petekaik/esp32-c3-sensor-board/case/renders/cand_a_stepped_iso.png

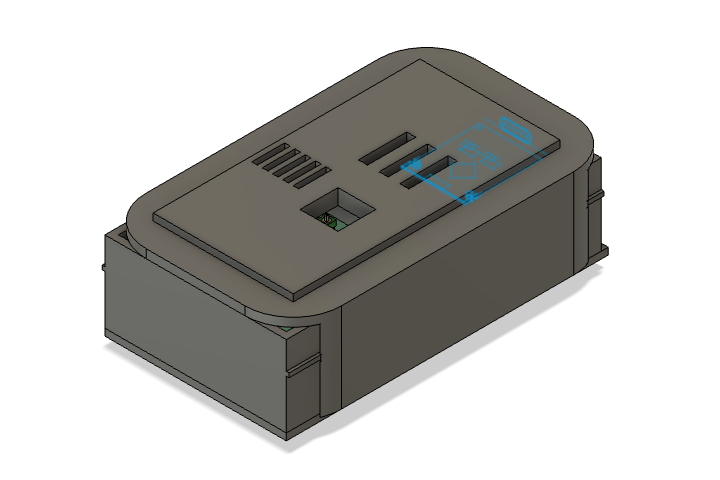
case/renders/cand_a_stepped_iso.png
