petekaik/esp32-c3-sensor-board/case/renders/cand_b_wavy_side.png

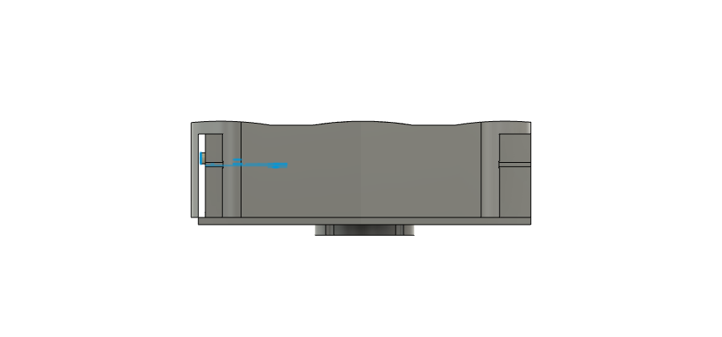
case/renders/cand_b_wavy_side.png
