petekaik/esp32-c3-sensor-board/case/renders/compact_case_faceplate.png

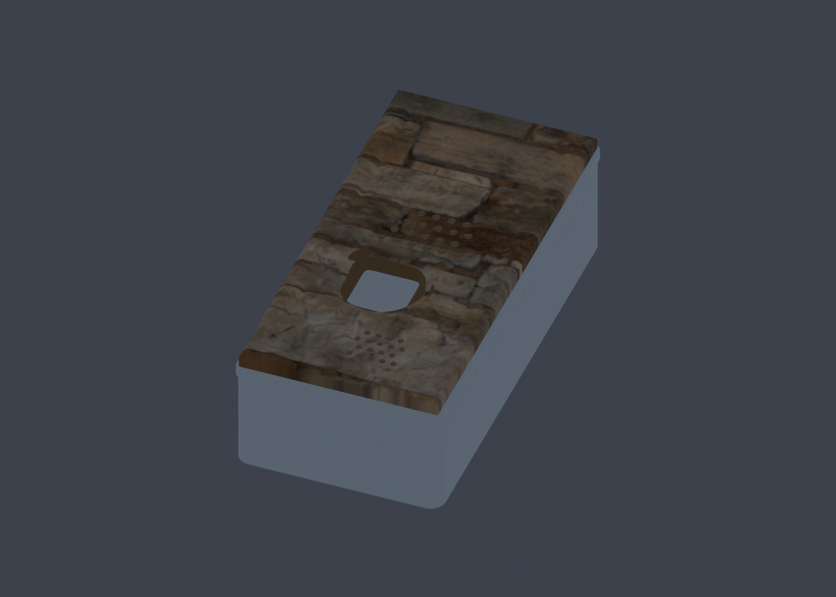
case/renders/compact_case_faceplate.png
