petekaik/esp32-c3-sensor-board/case/renders/faceplate_compact.png

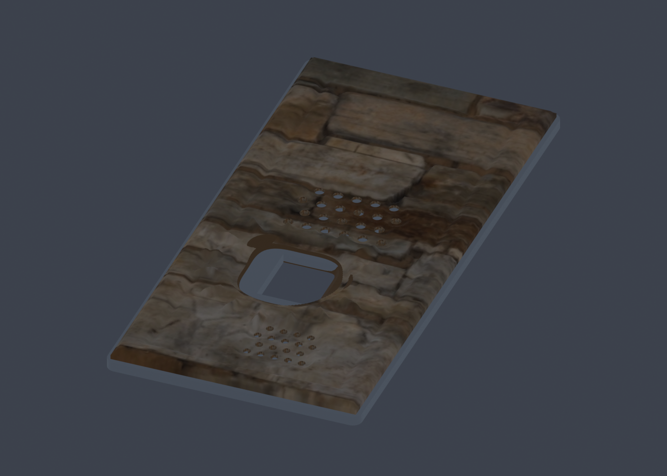
case/renders/faceplate_compact.png
