petekaik/esp32-c3-sensor-board/case/renders/faceplate_organic.png

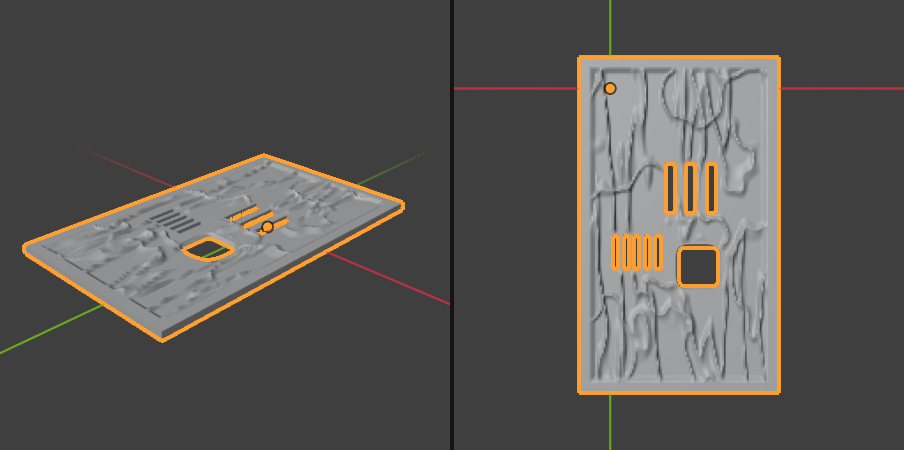
case/renders/faceplate_organic.png
