petekaik/esp32-c3-sensor-board/docs/img/board-compact.png

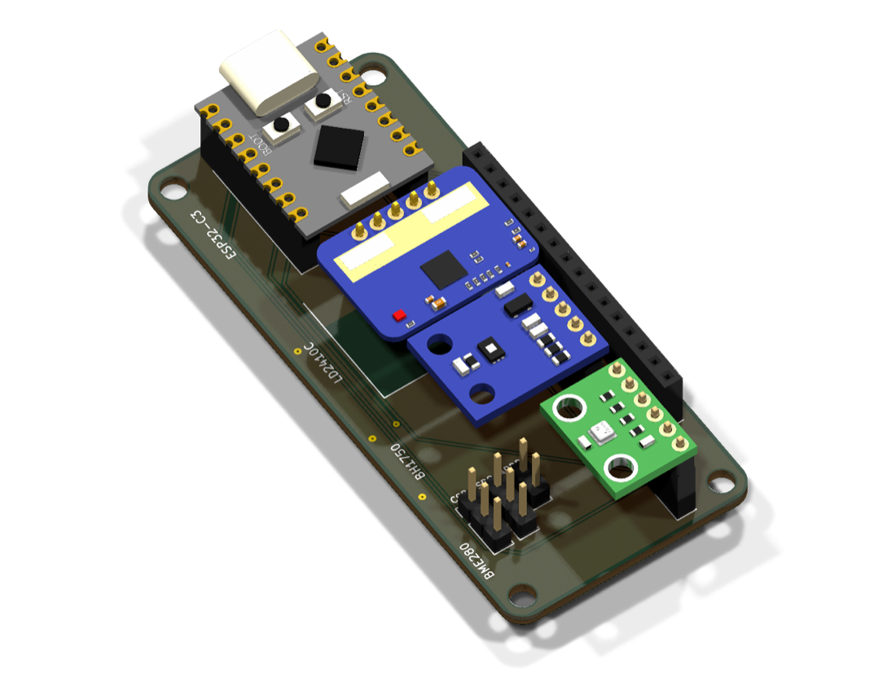
docs/img/board-compact.png
