petekaik/esp32-c3-sensor-board/docs/img/board-rev3.png

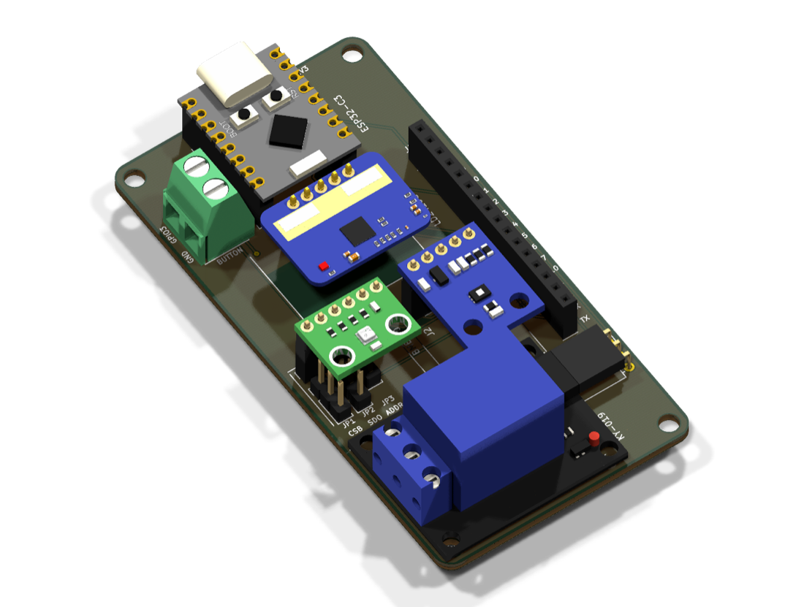
docs/img/board-rev3.png
