petekaik/esp32-c3-sensor-board/docs/BOM-compact.csv

Ref | Value | Footprint | Qty | Notes
PCB | ESP32-C3 sensor carrier compact | 2-layer 34 x 76 mm | 1 | 1.6 mm FR4 R3 corners ENIG preferred
U1 | ESP32-C3 Super Mini | module 2x8 2.54 mm | 1 | plugs into two 1x8 sockets
U2 | HLK-LD2410C | module 1x5 2.54 mm | 1 | plugs into 1x5 socket
J1 | BME280 module | module 1x6 2.54 mm | 1 | BME680 in the bme680 variant
J2 | BH1750 GY-302 | module 1x5 2.54 mm | 1
S1 | 1x8 female socket 2.54 mm | PinSocket_1x08_P2.54mm_Vertical | 2 | U1A/U1B
S2 | 1x5 female socket 2.54 mm | PinSocket_1x05_P2.54mm_Vertical | 2 | U2 and J2
S3 | 1x6 female socket 2.54 mm | PinSocket_1x06_P2.54mm_Vertical | 1 | J1
J5 | 1x16 female socket 2.54 mm | sensor-board:PinSocket_1x16_P2.54mm_Vertical | 1 | LCSC C7499334
JP1 | 1x3 pin header 2.54 mm | PinHeader_1x03_P2.54mm_Vertical | 1 | I2C / SPI select
JP2 | 1x3 pin header 2.54 mm | PinHeader_1x03_P2.54mm_Vertical | 1 | address / SPI MISO select
JP3 | 1x2 pin header 2.54 mm | PinHeader_1x02_P2.54mm_Vertical | 1 | address select
SHUNT | 2.54 mm jumper shunt | generic | 3 | one per jumper
H1-H4 | M3 mounting hole | 3.2 mm drill | 4 | no hardware included
