petekaik/esp32-c3-sensor-board/fabrication/bom-jlc.csv

Designator | Footprint | Quantity | Value | LCSC Part #
J1 | PinSocket_1x06_P2.54mm_Vertical | 1 | 1x6 female socket 2.54 mm | C40877
J2 | PinSocket_1x05_P2.54mm_Vertical | 1 | 1x5 female socket 2.54 mm | C50950
J4 | TerminalBlock_MaiXu_MX126-5.0-02P_1x02_P5.00mm | 1 | Button | C5188434
J5 | PinSocket_1x14_P2.54mm_Vertical | 1 | GPIO | C41417326
JP1 | PinHeader_1x03_P2.54mm_Vertical | 1 | CSB_I2C | C49257
JP2 | PinHeader_1x03_P2.54mm_Vertical | 1 | SDO_ADDR | C49257
JP3 | PinHeader_1x02_P2.54mm_Vertical | 1 | ADDR_GND | C32713268
U1A, U1B | PinSocket_1x08_P2.54mm_Vertical | 2 | 1x8 female socket 2.54 mm | C27438
U2 | ld2410c | 1 | 1x5 female socket 2.54 mm | C50950
