petekaik/esp32-c3-sensor-board/fabrication/assembly/vendor-neutral-bom.csv

Ref | Part | Footprint | Pitch | Qty | Notes | LCSC | Aisler MPN | PCBWay/JLC note
U1A | 1x8 female socket 2.54 mm | PinSocket_1x08_P2.54mm_Vertical | 2.54 | 1 | U1 pads 1-8 | C27438 | 2.54-1*8P
U1B | 1x8 female socket 2.54 mm | PinSocket_1x08_P2.54mm_Vertical | 2.54 | 1 | U1 pads 9-16 | C27438 | 2.54-1*8P
U2 | 1x5 female socket 2.54 mm | PinSocket_1x05_P2.54mm_Vertical | 2.54 | 1 | LD2410C socket | C50950 | 2.54-1*5P
J1 | 1x6 female socket 2.54 mm | PinSocket_1x06_P2.54mm_Vertical | 2.54 | 1 | BME280/BME680 | C40877 | 2.54-1*6P
J2 | 1x5 female socket 2.54 mm | PinSocket_1x05_P2.54mm_Vertical | 2.54 | 1 | BH1750 | C50950 | 2.54-1*5P
J3 | 1x3 right-angle female socket 2.54 mm | PinSocket_1x03_P2.54mm_Horizontal | 2.54 | 1 | relay; hand-solder long-pin | C54876732 | excluded - hand-solder
J4 | 2-pin screw terminal 5.0 mm | TerminalBlock_MaiXu_MX126-5.0-02P | 5.00 | 1 | button | C5188434 | MX126-5.0-02P-GN01-Cu-S-A
J5 | 1x14 female socket 2.54 mm | PinSocket_1x14_P2.54mm_Vertical | 2.54 | 1 | breakout row | C41417326 | SSW-114-01-T-S | LCSC code not in Aisler catalogue
JP1 | 1x3 pin header 2.54 mm | PinHeader_1x03_P2.54mm_Vertical | 2.54 | 1 | I2C/SPI select | C49257 | TSW-103-07-G-S
JP2 | 1x3 pin header 2.54 mm | PinHeader_1x03_P2.54mm_Vertical | 2.54 | 1 | address/SPI MISO | C49257 | TSW-103-07-G-S
JP3 | 1x2 pin header 2.54 mm | PinHeader_1x02_P2.54mm_Vertical | 2.54 | 1 | address | C32713268 | HX PZ2.54-1x2P ZZ
SHUNT | 2.54 mm jumper shunt | generic | 2.54 | 3 | one per jumper | C5305 | not in Aisler CAD BOM | hand-fit
 | ESP32-C3 Super Mini | module |  | 1 | EXCLUDED - plug-in
 | HLK-LD2410C | module |  | 1 | EXCLUDED - plug-in
 | BME280 (or BME680) | module |  | 1 | EXCLUDED - plug-in
 | BH1750 GY-302 | module |  | 1 | EXCLUDED - plug-in
 | KY-019 relay | module |  | 1 | EXCLUDED - plug-in
