petekaik/esp32-c3-sensor-board/case/compact_cover.stl

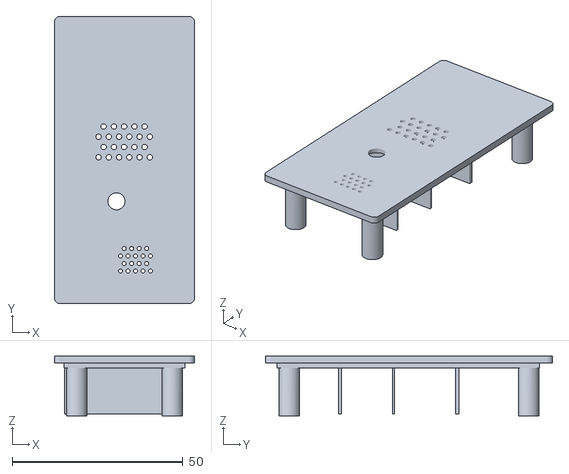
[picture p10: CAD file, 2026-11-02]
case/compact_cover.stl
41.0 x 84.0 x 17.5
