petekaik/esp32-c3-sensor-board/case/compact_tray.stl

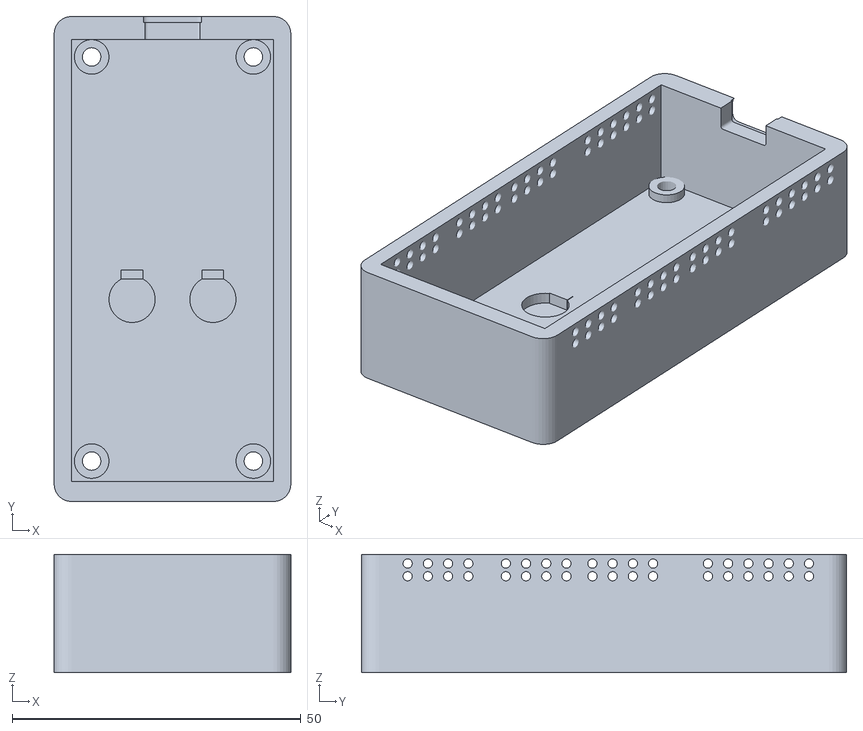
[picture p11: CAD file, 2026-11-01]
case/compact_tray.stl
41.0 x 84.0 x 20.5
