petekaik/esp32-c3-sensor-board/case/compact_mount.stl

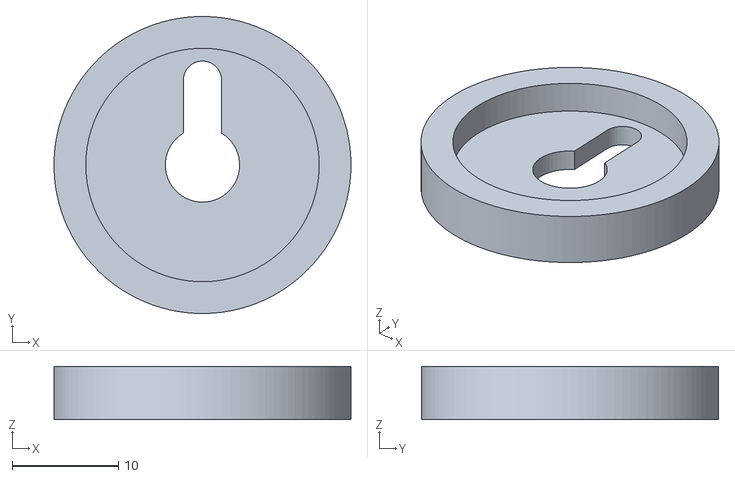
[picture p12: CAD file, 2026-11-01]
case/compact_mount.stl
28.0 x 28.0 x 5.00
