petekaik/esp32-c3-sensor-board/case/faceplate_compact.stl

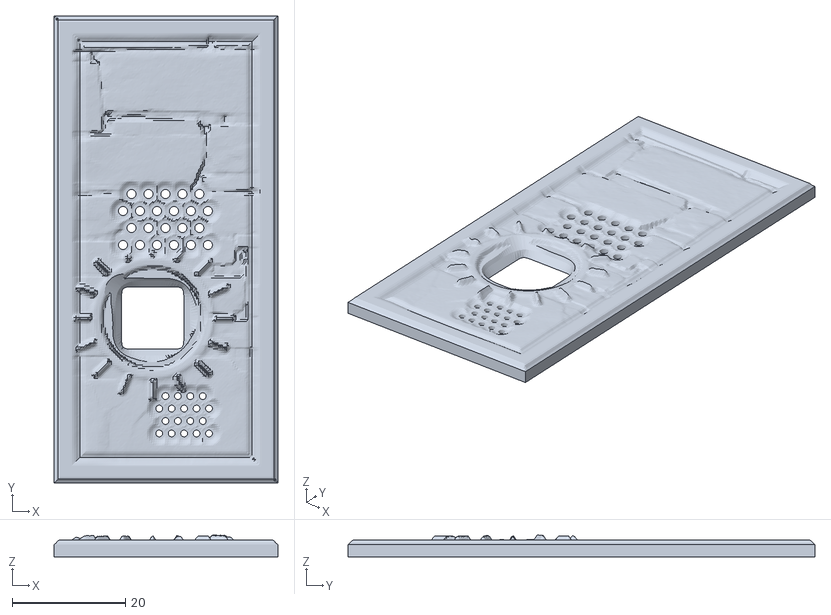
[picture p13: CAD file, 2026-11-01]
case/faceplate_compact.stl
39.5 x 82.5 x 3.85
