petekaik/esp32-c3-sensor-board/case/tray.stl

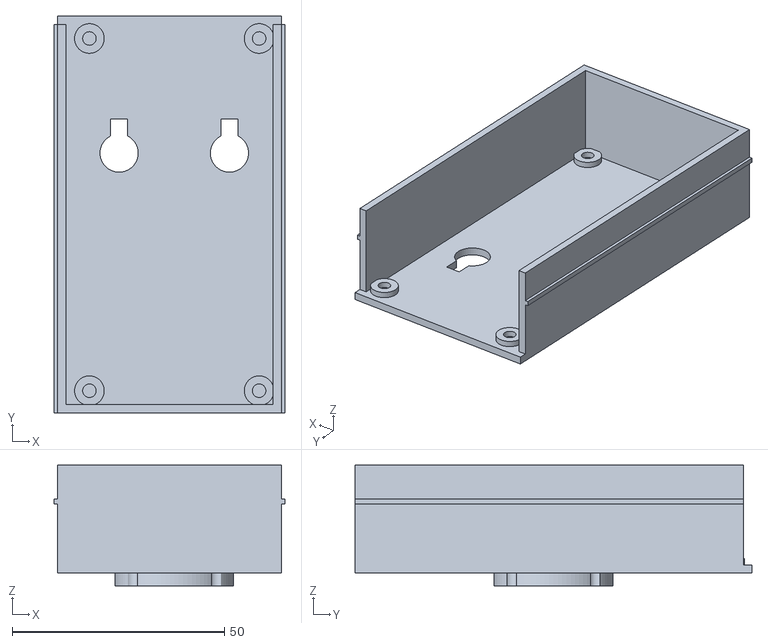
[picture p14: CAD file, 2026-10-31]
case/tray.stl
54.3 x 93.5 x 28.5
