petekaik/esp32-c3-sensor-board/case/faceplate.stl

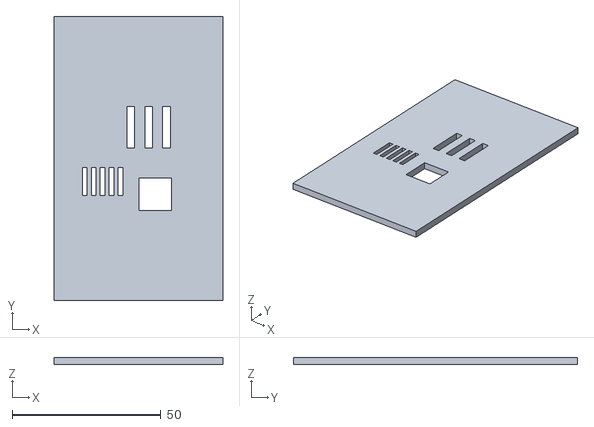
[picture p15: CAD file, 2026-10-31]
case/faceplate.stl
56.8 x 95.6 x 2.50
