petekaik/esp32-c3-sensor-board/case/faceplate_organic.stl

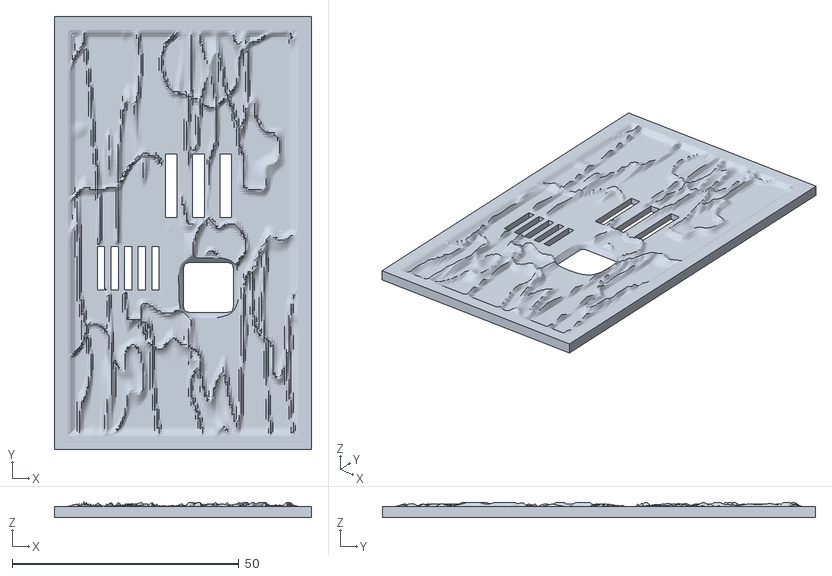
[picture p16: CAD file, 2026-10-31]
case/faceplate_organic.stl
56.8 x 95.6 x 3.35
