petekaik/esp32-c3-sensor-board/case/board-rev2.step

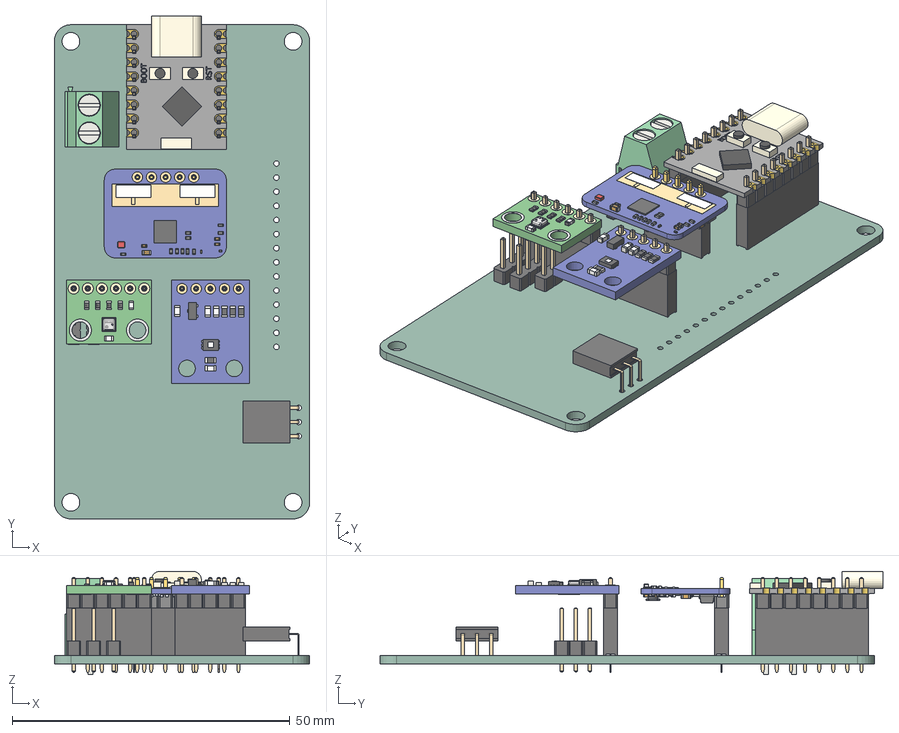
[picture p17: CAD file, 2026-10-31]
case/board-rev2.step
46.0 x 90.6 x 18.6 mm
PinHeader_1x03_P254mm_Vertical x 2
PinHeader_1x02_P254mm_Vertical
TerminalBlock_Phoenix_MKDS-1,5-2_1x02_P5.00mm_Horizontal
PinSocket_1x03_P2.54mm_Horizontal
PinSocket_1x08_P2.54mm_Vertical x 2
PinHeader_1x08_P254mm_Vertical x 2
R_0201 x 2
LOGO? x 2
LOGO? (1) x 2
C_0201 x 2
LOGO? (2) x 12
C_0402 x 12
R_0402 x 18
LOGO? (3) x 18
SOT89
LOGO?0.25
Extruded
Extruded (1)
NR2520
LOGO?0.15
HDR2.54-1P x 5
LOGO? (4) x 5
LED_0805
OSC_2025-4 x 2
LOGO?0.15 (1) x 2
R_0603
LOGO? (5)
LOGO? (6)
LOGO? (7) x 4
C_0603 x 4
PinSocket_1x05_P2.54mm_Vertical x 2
PinHeader_1x05_P254mm_Vertical
(Unsaved)
PinSocket_1x06_P2.54mm_Vertical
PinHeader_1x06_P254mm_Vertical
BME280 v1
_export_tmp_PCB
