petekaik/esp32-c3-sensor-board/case/cover_open.stl

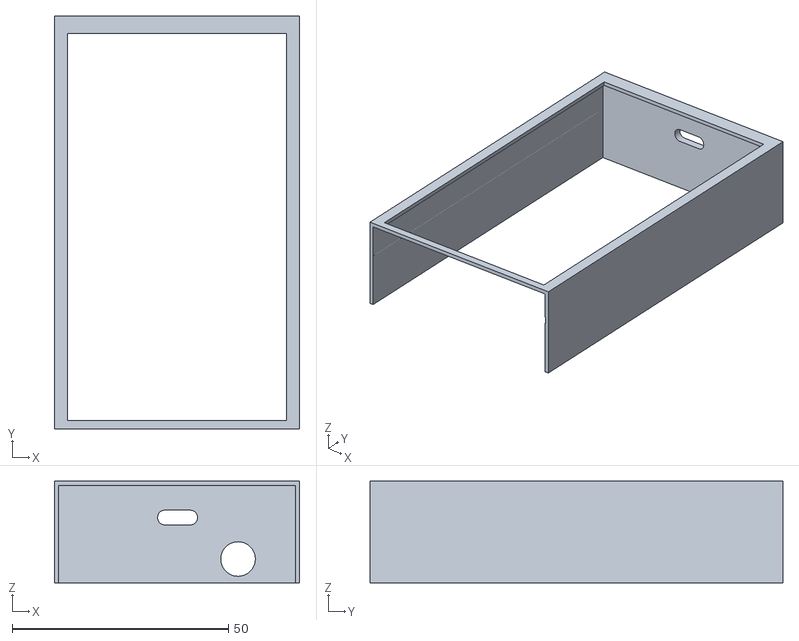
[picture p18: CAD file, 2026-10-31]
case/cover_open.stl
56.8 x 95.6 x 23.5
