petekaik/esp32-c3-sensor-board/(list of files, cad)

Other CAD files:
case/compact_faceplate.blend
