petekaik/esp32-c3-sensor-board/hardware/esp32-c3-sensor-board-compact.kicad_pcb

## KiCad design hardware/esp32-c3-sensor-board-compact.kicad_pcb (2026-10-31)

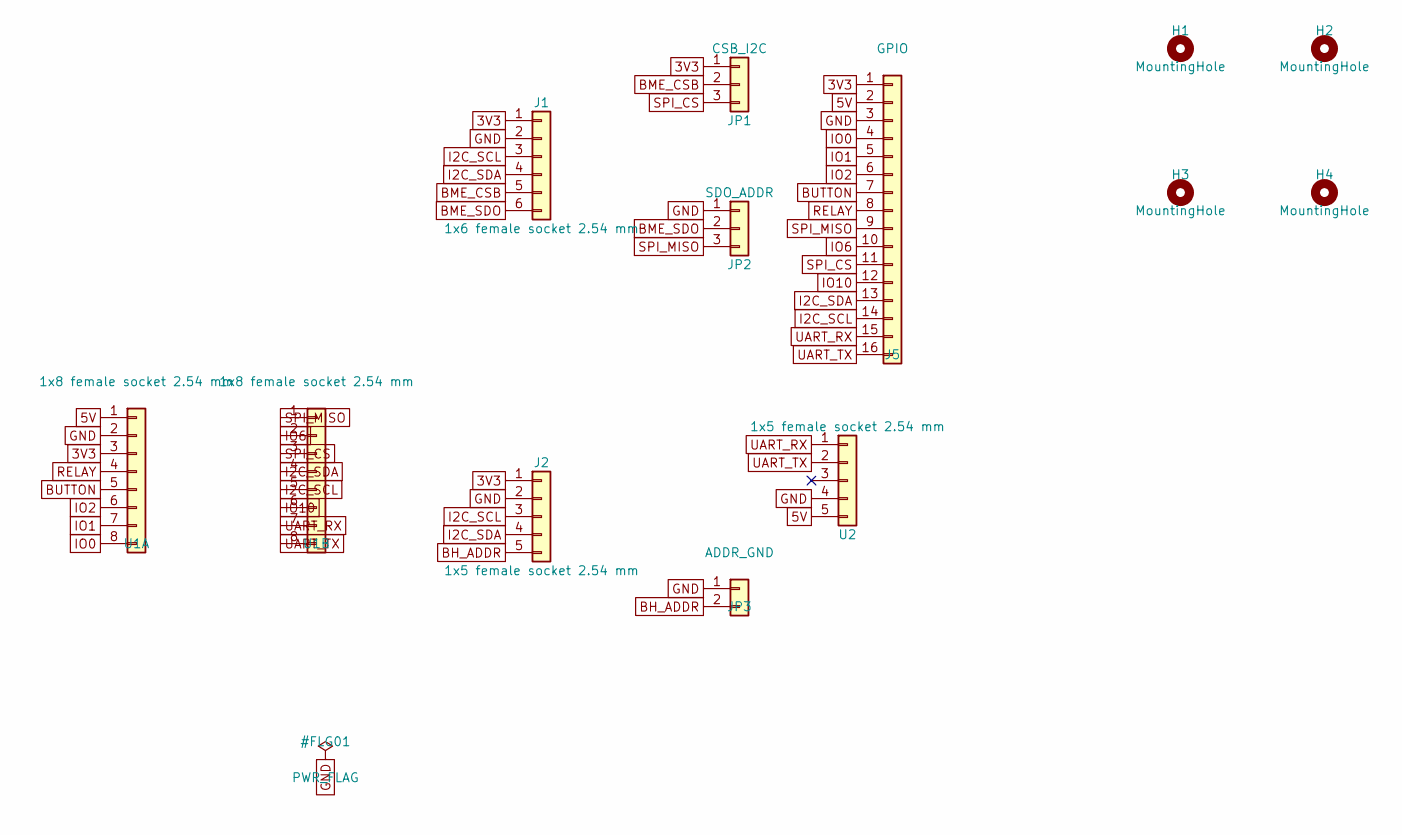
[picture p19: schematic esp32-c3-sensor-board-compact.kicad_sch]

Parts:
H1, H2, H3, H4: MountingHole; MountingHole_3.2mm_M3
J1: 1x6 female socket 2.54 mm; PinSocket_1x06_P2.54mm_Vertical; LCSC C40877
J2: 1x5 female socket 2.54 mm; PinSocket_1x05_P2.54mm_Vertical; LCSC C50950
J5: GPIO; PinSocket_1x16_P2.54mm_Vertical; LCSC C7499334
JP1: CSB_I2C; PinHeader_1x03_P2.54mm_Vertical; LCSC C49257
JP2: SDO_ADDR; PinHeader_1x03_P2.54mm_Vertical; LCSC C49257
JP3: ADDR_GND; PinHeader_1x02_P2.54mm_Vertical; LCSC C32713268
U1A, U1B: 1x8 female socket 2.54 mm; PinSocket_1x08_P2.54mm_Vertical; LCSC C27438
U2: 1x5 female socket 2.54 mm; ld2410c_compact; LCSC C50950

Connections:
3V3: J1.1, J2.1, J5.1, JP1.1, U1A.3
5V: J5.2, U1A.1, U2.5
BH_ADDR: J2.5, JP3.2
BME_CSB: J1.5, JP1.2
BME_SDO: J1.6, JP2.2
BUTTON: J5.7, U1A.5
GND: J1.2, J2.2, J5.3, JP2.1, JP3.1, U1A.2, U2.4
I2C_SCL: J1.3, J2.3, J5.14, U1B.5
I2C_SDA: J1.4, J2.4, J5.13, U1B.4
IO0: J5.4, U1A.8
IO1: J5.5, U1A.7
IO2: J5.6, U1A.6
IO6: J5.10, U1B.2
IO10: J5.12, U1B.6
RELAY: J5.8, U1A.4
SPI_CS: J5.11, JP1.3, U1B.3
SPI_MISO: J5.9, JP2.3, U1B.1
UART_RX: J5.15, U1B.7, U2.1
UART_TX: J5.16, U1B.8, U2.2

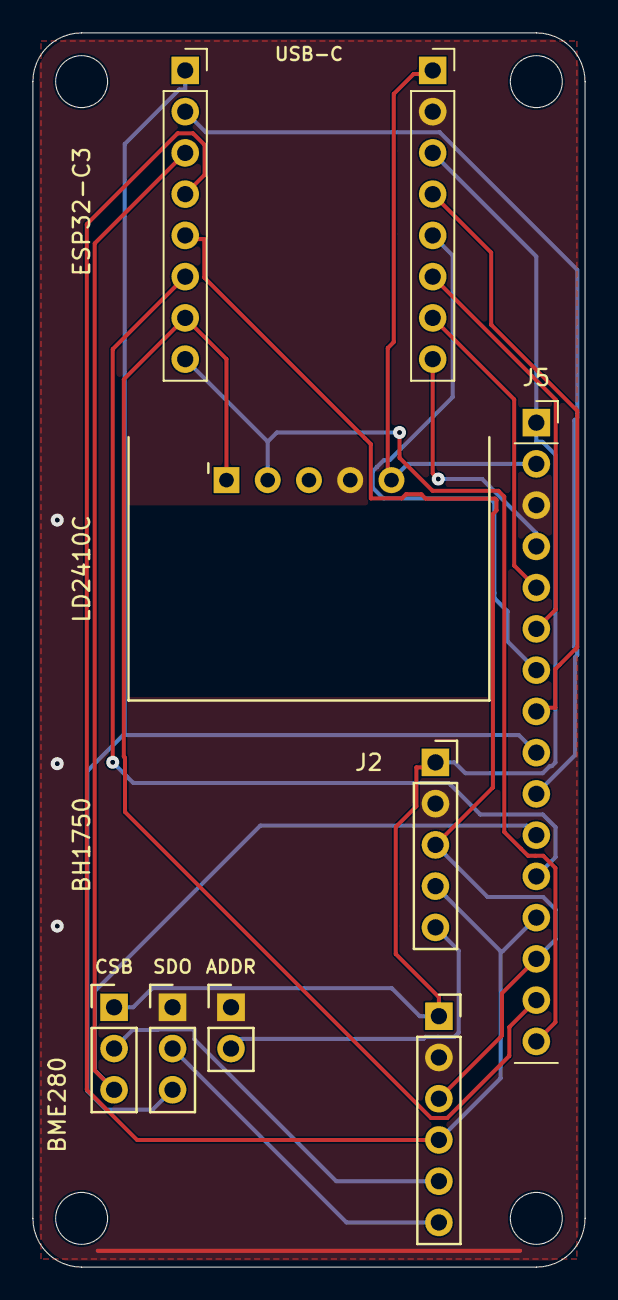
[picture p20: board esp32-c3-sensor-board-compact.kicad_pcb from above]

Board: 2 copper layers, 34.0 x 76.0 mm, 13 parts (0 on the bottom side), 19 nets.
