petekaik/esp32-c3-sensor-board/hardware/esp32-c3-sensor-board.kicad_pcb

## KiCad design hardware/esp32-c3-sensor-board.kicad_pcb (2026-10-29, an earlier design)

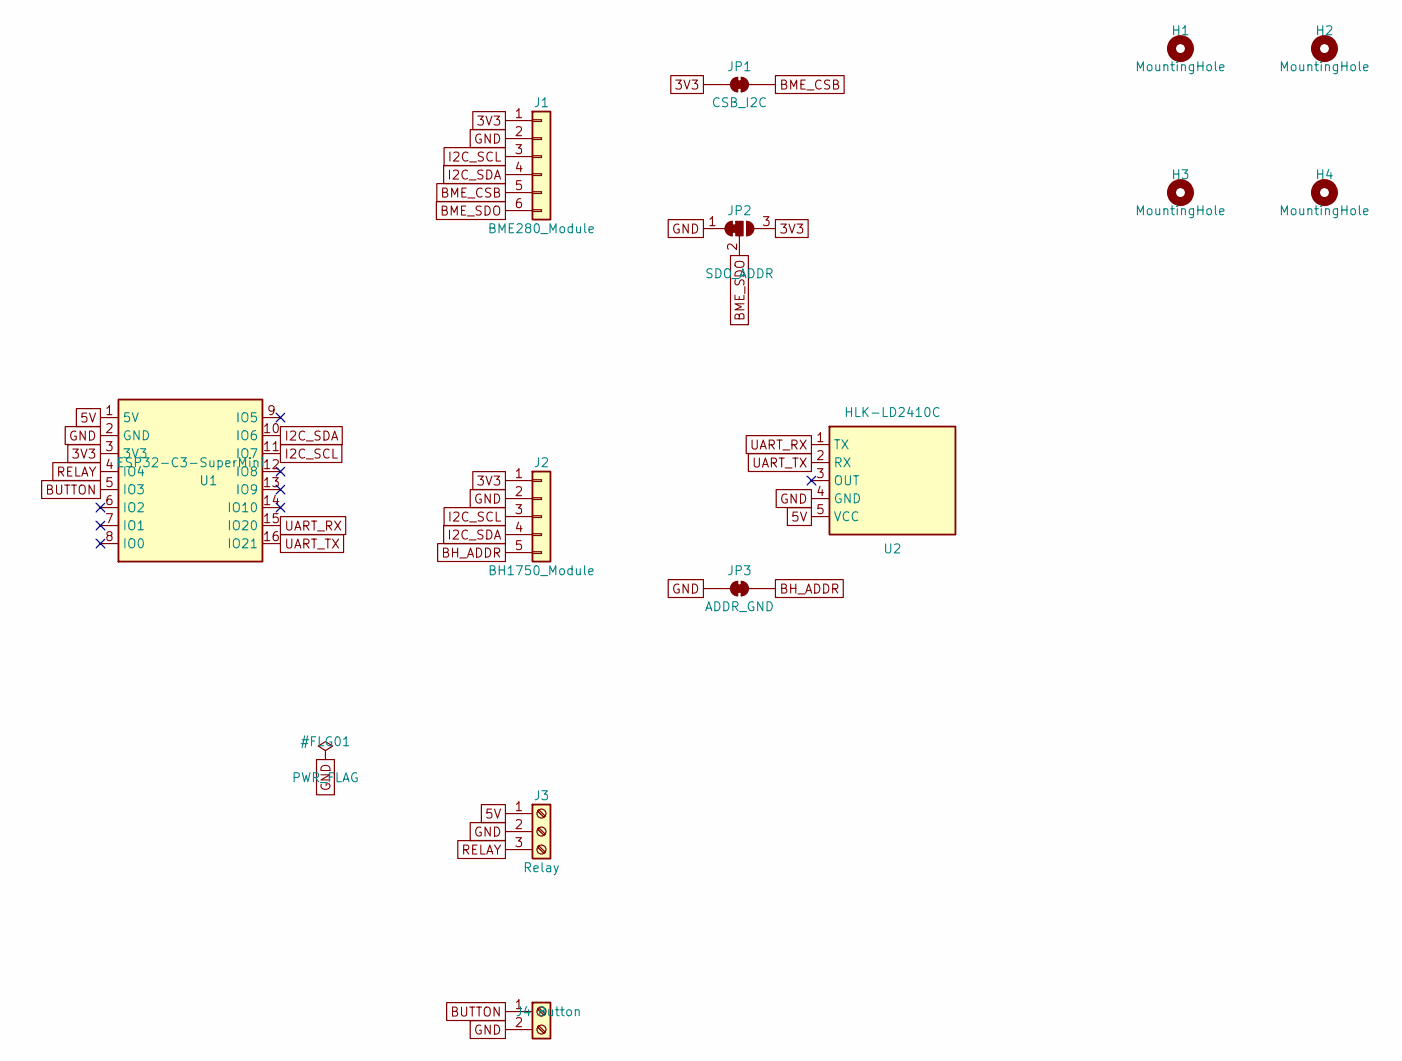
[picture p23: schematic esp32-c3-sensor-board.kicad_sch]

Parts:
H1, H2, H3, H4: MountingHole; MountingHole_3.2mm_M3
J1: BME280_Module; PinSocket_1x06_P2.54mm_Vertical
J2: BH1750_Module; PinSocket_1x05_P2.54mm_Vertical
J3: Relay; TerminalBlock_MaiXu_MX126-5.0-03P_1x03_P5.00mm
J4: Button; TerminalBlock_MaiXu_MX126-5.0-02P_1x02_P5.00mm
JP1: CSB_I2C; SolderJumper-2_P1.3mm_Bridged_RoundedPad1.0x1.5mm
JP2: SDO_ADDR; SolderJumper-3_P1.3mm_Bridged12_RoundedPad1.0x1.5mm
JP3: ADDR_GND; SolderJumper-2_P1.3mm_Bridged_RoundedPad1.0x1.5mm
U1: ESP32-C3-SuperMini; ESP32-C3-SuperMini_Socket
U2: HLK-LD2410C; ld2410c

Connections:
3V3: J1.1, J2.1, JP1.1 (A), JP2.3 (B), U1.3 (3V3)
5V: J3.1, U1.1 (5V), U2.5 (VCC)
BH_ADDR: J2.5, JP3.2 (B)
BME_CSB: J1.5, JP1.2 (B)
BME_SDO: J1.6, JP2.2 (C)
BUTTON: J4.1, U1.5 (IO3)
GND: J1.2, J2.2, J3.2, J4.2, JP2.1 (A), JP3.1 (A), U1.2 (GND), U2.4 (GND)
I2C_SCL: J1.3, J2.3, U1.11 (IO7)
I2C_SDA: J1.4, J2.4, U1.10 (IO6)
RELAY: J3.3, U1.4 (IO4)
UART_RX: U1.15 (IO20), U2.1 (TX)
UART_TX: U1.16 (IO21), U2.2 (RX)

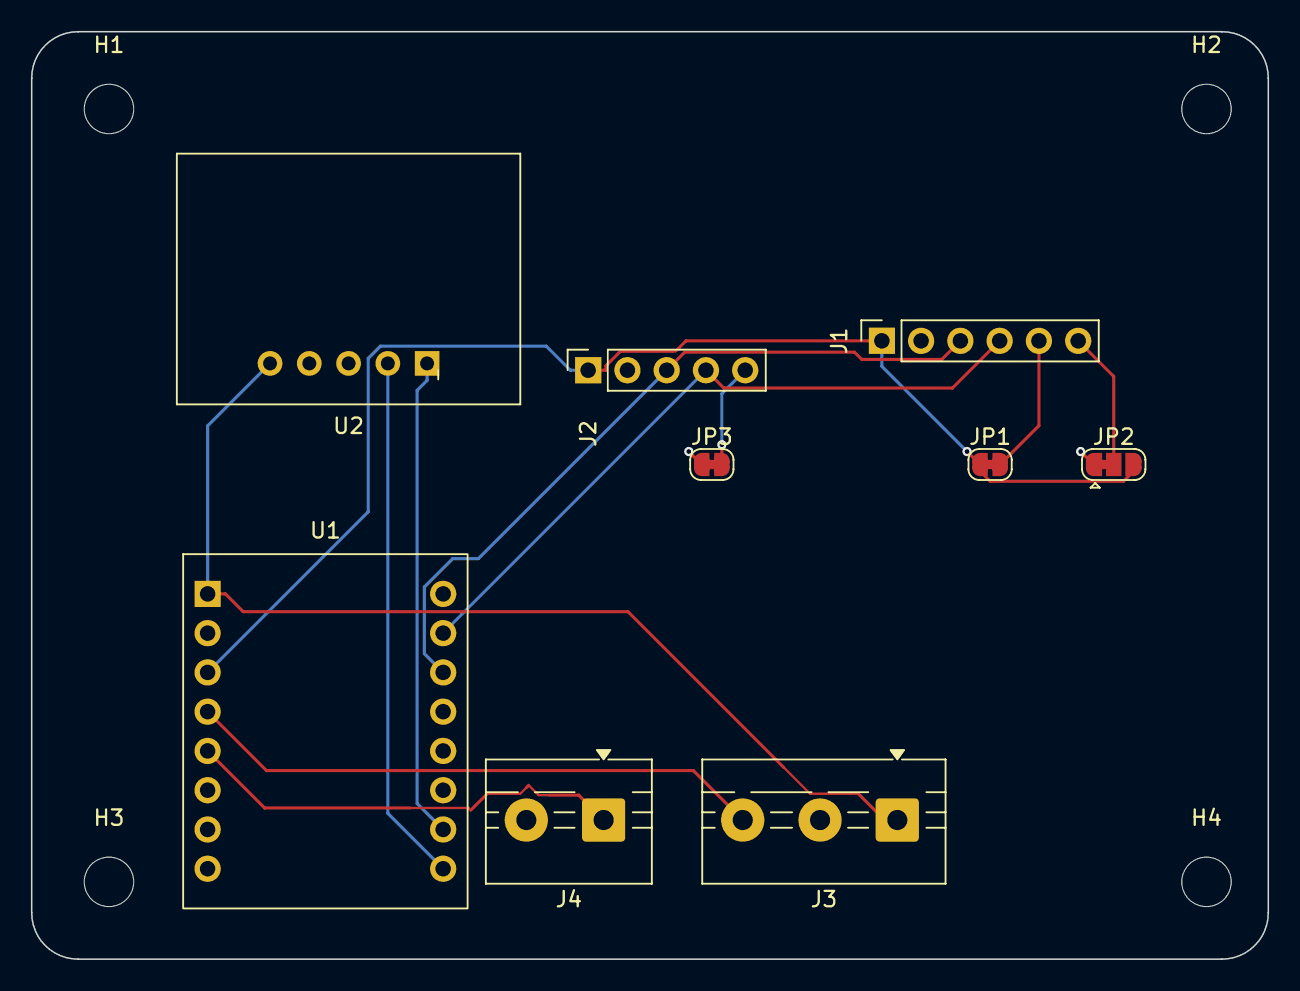
[picture p24: board esp32-c3-sensor-board.kicad_pcb from above]

Board: 2 copper layers, 80.0 x 60.0 mm, 13 parts (0 on the bottom side), 12 nets.
