petekaik/esp32-c3-sensor-board/(commit log)

2026-10-29 Add rev2 carrier board, 3D models and user documentation
    - KiCad 10 project (46x89 mm rev2): schematic, PCB, libraries, 3D models
    - ESP32-C3 Super Mini carrier with BME280, BH1750, LD2410C, relay and button
    - Jumper-selectable I2C/SPI, 1x14 breakout row
    - README, pin map, BOM, variant pages and GitHub Pages HTML
    [BOM.csv, esp32-c3-sensor-board-rev2.kicad_pcb, esp32-c3-sensor-board-rev2.kicad_sch, esp32-c3-sensor-board.kicad_pcb, esp32-c3-sensor-board.kicad_sch]
2026-10-30 Add fabrication outputs, case board STEP, quote tools and pricing docs
    - fabrication/: JLCPCB-ready gerbers (7 layers + job + drill), BOM/CPL, QUOTE
    - case/board-rev2.step: board assembly STEP exported for enclosure modelling
    - tools/aisler_quote.py, tools/kicad-plugin/: quoting helper and KiCad action plugin
    - docs/pricing.md: board + assembly cost notes
    - hardware: rev2 PCB updates and rebuilt ky019.step (right-angle relay module)
    - HANDOFF/README: session notes
    [board-rev2.step, bom-jlc.csv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]
2026-10-31 Add case faceplate: flat plate, sensor cut-outs, Blender deck pass
    - case/faceplate.stl: 56.75 x 95.55 x 2.5 mm plate from the cover top-plate
    volume (x -6.5..50.25, y -91.25..4.3, z 22..24.5) with the five BME louvres,
    BH1750 window and three radar vents cut through
    - case/faceplate_sculpted.stl: Blender pass - 6 mm border frame, 0.8 mm
    recessed deck, three bezel islands around the sensor clusters, 0.35 mm bevel
    - case/renders/: candidate cover renders and the faceplate pass
    - HANDOFF: case rebuild recipe, lost-work note, Fusion MCP quirks
    [faceplate.stl, faceplate_sculpted.stl]
2026-10-31 Fix ESP32-C3 Super Mini pinout and re-route rev2
    - Correct the U1 socket footprint pad order to match the physical module
    (pad 1 = 5V at the USB end, pad 8 = GPIO0, pad 9 = GPIO5, pad 16 = GPIO21).
    - Use the reference pinout for I2C: SDA = GPIO8, SCL = GPIO9; free GPIO6/7
    go to the J5 breakout row. UART stays GPIO20/21, relay GPIO4, button GPIO3.
    - Add full pin descriptions to the ESP32 symbol and board silkscreen
    (GPIOx plus MISO/MOSI/SS/SDA/SCL/RX/TX), and update all docs.
    - Re-route the board against the corrected pin order (FreeRouting);
    DRC 0 errors / 0 unconnected, 2 pre-existing cosmetic silk warnings.
    - Regenerate gerbers, drill, job file and the gerber zip.
    doorbell.yml sti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
    [esp32-c3-sensor-board-rev2-B_Cu.gbl, esp32-c3-sensor-board-rev2-B_Mask.gbs, esp32-c3-sensor-board-rev2-B_Silkscreen.gbo, esp32-c3-sensor-board-rev2-Edge_Cuts.gm1, esp32-c3-sensor-board-rev2-F_Cu.gtl, esp32-c3-sensor-board-rev2-F_Mask.gts, esp32-c3-sensor-board-rev2-F_Silkscreen.gto, esp32-c3-sensor-board-rev2-job.gbrjob]
2026-10-31 Add organic vein/grain faceplate generator and STL
    - tools/blender/make_faceplate.py: rebuilds the faceplate as a heightfield
    with a stretched-noise vein field, flat border rim, recessed deck, the
    mandatory louvre/vent openings and a lofted BH1750 funnel that lands on the
    exact 11x11 mm sensor opening at the bottom face
    - case/faceplate_organic.stl: manifold, 56.75 x 95.55 x 3.35 mm, support-free
    - case/renders/faceplate_organic.png, faceplate_v1.png
    - HANDOFF: faceplate route and how to re-run the generator
    [faceplate_organic.stl]
2026-10-31 Ignore .claude/ (embedded worktree got staged)
2026-10-31 Align BME280 SPI option with the ESP32-C3 reference pinout
    - SPI_MISO moves from GPIO10 to GPIO5 (reference MISO)
    - SPI_CS moves from GPIO5 to GPIO7 (reference SS)
    - GPIO10 is now a free J5 breakout pin
    - I2C stays SDA=GPIO8 / SCL=GPIO9; UART GPIO20/21; relay GPIO4; button GPIO3
    - Re-route the affected nets; DRC 0 errors / 0 unconnected (2 cosmetic silk warnings)
    - Update JP1/JP2 silkscreen legends and all pin-map docs
    - Regenerate gerbers, drill, job file and gerber zip
    The schematic symbol now maps: GPIO5/MISO->SPI_MISO, GPIO7/SS->SPI_CS,
    GPIO8/SDA->I2C_SDA, GPIO9/SCL->I2C_SCL, GPIO20/RX->UART_RX, GPIO21/TX->UART_TX.
    BME280 SPI mode reuses SCL/SDA as SCK/MOSI (GPIO9/GPIO8), since the modu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
    [esp32-c3-sensor-board-rev2-B_Cu.gbl, esp32-c3-sensor-board-rev2-B_Mask.gbs, esp32-c3-sensor-board-rev2-B_Silkscreen.gbo, esp32-c3-sensor-board-rev2-Edge_Cuts.gm1, esp32-c3-sensor-board-rev2-F_Cu.gtl, esp32-c3-sensor-board-rev2-F_Mask.gts, esp32-c3-sensor-board-rev2-F_Silkscreen.gto, esp32-c3-sensor-board-rev2-job.gbrjob]
2026-10-31 Integrate organic faceplate: open cover with seating ledge, print-ready STLs
    - Fusion: COVER_OPEN (COVER_SLIDE with the lid removed above z 22 plus a 2 mm
    seating ledge), TRAY_UNION (seven tray bodies unioned), FACEPLATE mesh body
    seated at z 22..25.35
    - case/cover_open.stl, case/tray.stl exported at 1:1 mm
    - tightened the grain: thinner veins (GRAIN_CUT 0.058 / BRANCH_CUT 0.042) and a
    closer root mask so the sensor clearings shrink
    - drop the superseded faceplate_sculpted.stl
    - HANDOFF: assembly layout, STL list, Fusion API gotchas (deleteMe side effects,
    mesh winding, body renaming, same-script export)
    [cover_open.stl, faceplate_organic.stl, faceplate_sculpted.stl, tray.stl]
2026-10-31 Add KY-019 relay 3D model to J3 for populated rendering
    Restore the relay module STEP (hardware/lib/models/ky019.step) to J3 so the
    KiCad 3D viewer shows the fully populated board. The offset was retuned for
    rev2's J3 placement at (44, 69): (0, 5.08, 1) aligns the module's 3-pin
    header with J3 and places the body over the bottom wiring area instead of
    hanging off the left edge.
    Note: kicad-cli pcb export step still ignores J3's model transform (see
    HANDOFF.md); the case assembly keeps its manually placed relay model.
    [esp32-c3-sensor-board-rev2.kicad_pcb]
2026-10-31 Align KY-019 relay 3D model on J3
    Set the relay model offset to (0, 0.16, 0) mm after manual alignment in
    the KiCad 3D viewer, so the populated board renders with the module seated
    at J3 and its screw terminals over the wiring area.
    [esp32-c3-sensor-board-rev2.kicad_pcb]
2026-10-31 Fit J5 as a standard 1x14 female socket
    Replace the bare breakout_1x14 footprint with the standard
    Connector_PinSocket_2.54mm:PinSocket_1x14_P2.54mm_Vertical at the same
    position (40, 25). Pad positions, drills and nets are unchanged; pad 1 is
    now the standard rectangular pin-1 marker and the socket has a 3D model.
    - Update the schematic J5 Footprint field so a future F8 keeps the socket.
    - Update the JLC BOM footprint row and all docs/QUOTE wording (J5 is now a
    fitted socket, not bare holes).
    - Refill zones and re-run DRC: 0 errors / 0 unconnected (2 cosmetic silk
    warnings).
    - Regenerate gerbers, drill, job file and gerber zip from the final board.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
    [bom-jlc.csv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]
2026-10-31 Add one-command lander (tools/land.sh)
    User-invoked helper: commit the current branch, push, open a PR if needed,
    merge it, and fast-forward the main worktree. Deliberately not a background
    automation; run it once when you want to land the work.
2026-10-31 Fix land.sh for linked worktrees
    gh pr merge --delete-branch tries to switch the current (linked) worktree to
    main, which fails when main is checked out in another worktree. Drop that flag
    and delete the remote branch explicitly; the final step fast-forwards the main
    worktree.
2026-10-31 Add per-provider assembly BOM/CPL with the real connectors
    The old BOM listed the plug-in modules (BME280_Module, ESP32-C3-SuperMini,
    Relay, ...), so JLCPCB tried to source modules instead of the sockets that
    are actually soldered. The new files list only the soldered connectors:
    - U1 is two 1x8 female sockets (U1A/U1B), not a 2x8 header.
    - U2 is a 1x5 socket for the LD2410C; J1 1x6, J2 1x5, J5 1x14, J3 1x3
    right-angle, J4 MX126-5.0-02P terminal, JP1/JP2 1x3 and JP3 1x2 male headers.
    - Modules (ESP32-C3 Super Mini, LD2410C, BME280, BH1750, relay) and NPTH
    mounting holes are excluded.
    Provider files added under fabrication/assembly/:
    - jlcpcb/ (Comment,Designator,Footprint,LCSC Part #;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
    [bom-aisler.csv, bom-jlc.csv, bom-jlcpcb.csv, bom-pcbway.csv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]
2026-10-31 Exclude J3 from assembly; add hand-solder guide
    J3's 2.54 mm 1x3 right-angle relay socket must be raised so its opening
    meets the KY-019 module's male header. Automated through-hole assembly places
    parts flush and cannot hold a part on a spacer, so remove J3 from every
    provider BOM/CPL (JLCPCB, PCBWay, Aisler and the top-level JLCPCB files) and
    add fabrication/assembly/hand-solder-j3.md with the part, approximate height
    and procedure.
    The board and gerbers are unchanged; the J3 pads remain for hand-soldering.
    The assembly files now contain 10 placements; the other nine connectors are
    assembled by the provider.
    [bom-aisler.csv, bom-jlc.csv, bom-jlcpcb.csv, bom-pcbway.csv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]
2026-10-31 Add JP1/JP2/JP3 pin-number labels on the bottom silkscreen
    The jumper pins had no visible numbering. Add mirrored 1-3 numbers next to
    each column on B.Silk (1-2 for JP3) and the JP1/JP2/JP3 column names below
    them. The bottom is where the shunts are fitted and is not covered by the
    BME280 module.
    Remove the large B.Silk jumper boxes to make room for the numbers; the short
    1-2 default-pair ticks remain. The front JP1/JP2/JP3 and CSB/SDO/ADDR labels
    are unchanged.
    Update README and docs/pinout with the pin-numbering note. Regenerate gerbers,
    drill, job file and zip. DRC 0 errors / 0 unconnected (2 cosmetic silk
    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
    [esp32-c3-sensor-board-rev2-B_Cu.gbl, esp32-c3-sensor-board-rev2-B_Mask.gbs, esp32-c3-sensor-board-rev2-B_Silkscreen.gbo, esp32-c3-sensor-board-rev2-Edge_Cuts.gm1, esp32-c3-sensor-board-rev2-F_Cu.gtl, esp32-c3-sensor-board-rev2-F_Mask.gts, esp32-c3-sensor-board-rev2-F_Silkscreen.gto, esp32-c3-sensor-board-rev2-job.gbrjob]
2026-10-31 Widen traces to 0.2 mm for Aisler's 35 um process
    Aisler's selected 2L 1.6 mm 35 um process requires 200 um minimum trace and
    150 um minimum space. The board had 46 trace segments at 150 um.
    - Widen all 46 segments to 0.20 mm.
    - Set the project netclass to 0.20 mm trace / 0.15 mm clearance, vias 0.6/0.3,
    min drill 0.3 mm and min via annular ring 0.15 mm.
    - DRC with those rules: 0 errors / 0 unconnected (2 cosmetic silk warnings).
    - Regenerate gerbers, drill, job file and zip.
    - Update README, QUOTE and CLAUDE routing parameters.
    The board now meets Aisler's minimum feature sizes (and still JLCPCB/PCBWay).
    [esp32-c3-sensor-board-rev2-B_Cu.gbl, esp32-c3-sensor-board-rev2-B_Mask.gbs, esp32-c3-sensor-board-rev2-B_Silkscreen.gbo, esp32-c3-sensor-board-rev2-Edge_Cuts.gm1, esp32-c3-sensor-board-rev2-F_Cu.gtl, esp32-c3-sensor-board-rev2-F_Mask.gts, esp32-c3-sensor-board-rev2-F_Silkscreen.gto, esp32-c3-sensor-board-rev2-job.gbrjob]
2026-10-31 Enlarge vias to 0.8 mm for AISLER annular-ring rule
    AISLER's 2L 1.6 mm 35 um process requires a 200 um via annular ring
    (175 um absolute minimum if the 0.3 mm drill is widened to 0.45 mm).
    The board's 0.6/0.3 mm vias gave only 150 um, which failed the upload
    check. Re-routed with 0.8/0.3 mm vias (250 um nominal ring), widened
    silkscreen to AISLER's 0.15 mm minimum, and regenerated gerbers/drill.
    DRC: 0 errors, 0 unconnected, 2 cosmetic silk warnings. ERC: 0.
    [esp32-c3-sensor-board-rev2-B_Cu.gbl, esp32-c3-sensor-board-rev2-B_Mask.gbs, esp32-c3-sensor-board-rev2-B_Silkscreen.gbo, esp32-c3-sensor-board-rev2-Edge_Cuts.gm1, esp32-c3-sensor-board-rev2-F_Cu.gtl, esp32-c3-sensor-board-rev2-F_Mask.gts, esp32-c3-sensor-board-rev2-F_Silkscreen.gto, esp32-c3-sensor-board-rev2-job.gbrjob]
2026-10-31 Restore strict DRC minimums after autoroute
    Freerouting reset min_track_width/min_clearance/min_via_* to its defaults.
    Set them back to the AISLER limits (0.2 mm track, 0.15 mm clearance,
    0.8 mm via, 0.2 mm annular, 0.3 mm drill/hole spacing).
2026-10-31 Route with 0.25 mm traces and 0.20 mm clearance
    The 0.20/0.15 mm board met AISLER's published minima but their own
    2-layer simple DRC template uses 0.20 mm clearance, which flagged 63
    clearance items. Re-routed with 0.25 mm traces, 0.20 mm clearance and
    0.8/0.3 mm vias (0.25 mm annular), and set the project rules to those
    values. Copper-to-edge is 0.354 mm (AISLER min 0.30).
    Verified with AISLER's exact 2-layer-simple project rules + .kicad_dru:
    0 errors. Own DRC: 0 errors / 0 unconnected (2 cosmetic silk warnings).
    ERC: 0. Gerbers/drill/zip regenerated; copper apertures C0.25/C0.8,
    silk C0.15, drill min 0.3 mm.
    [esp32-c3-sensor-board-rev2-B_Cu.gbl, esp32-c3-sensor-board-rev2-B_Mask.gbs, esp32-c3-sensor-board-rev2-B_Silkscreen.gbo, esp32-c3-sensor-board-rev2-Edge_Cuts.gm1, esp32-c3-sensor-board-rev2-F_Cu.gtl, esp32-c3-sensor-board-rev2-F_Mask.gts, esp32-c3-sensor-board-rev2-F_Silkscreen.gto, esp32-c3-sensor-board-rev2-job.gbrjob]
2026-10-31 Untent vias and clear silk from pads for AISLER
    AISLER's 2L 1.6 mm 35 um process does not support tented vias or
    silkscreen on pads. Both had been present on every version, so the
    upload error never changed.
    - Disable via tenting (board + per-via); mask layers now carry 0.9 mm
    via openings (0.8 mm via + 50 um mask expansion).
    - Set 50 um solder-mask expansion; 0.125 mm silk clearance rule.
    - Move U2 pin-1 silk marker 0.4 mm off pad 1 and update the library
    footprint to match.
    - Regenerate gerbers/drill/zip.
    AISLER's exact 2-layer-simple rules + .kicad_dru: 0 errors.
    Own DRC: 0 errors / 0 unconnected (26 cosmetic silk warnings).
    ERC: 0.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
    [esp32-c3-sensor-board-rev2-B_Cu.gbl, esp32-c3-sensor-board-rev2-B_Mask.gbs, esp32-c3-sensor-board-rev2-B_Silkscreen.gbo, esp32-c3-sensor-board-rev2-Edge_Cuts.gm1, esp32-c3-sensor-board-rev2-F_Cu.gtl, esp32-c3-sensor-board-rev2-F_Mask.gts, esp32-c3-sensor-board-rev2-F_Silkscreen.gto, esp32-c3-sensor-board-rev2-job.gbrjob]
2026-10-31 Case candidates, fabrication package, pricing docs, vendor-neutral BOM
    - Fusion/BLENDER case work notes and handoff sections
    - fabrication/: gerbers zip, JLCPCB BOM/CPL, quote sheet, assembly BOMs
    - docs/pricing.md + tools/aisler_quote.py + KiCad plugin
    - ky019 model offset baked; J3 socket only
    - vendor-neutral assembly BOM listing solder-in connectors, modules excluded
    [vendor-neutral-bom.csv]
2026-10-31 Make the BOM vendor-assignable and add three-vendor pricing
    Schematic: replace U1 with U1A/U1B (Conn_01x08) and U2 with Conn_01x05,
    keeping the existing global labels in place; J1/J2 renamed to connector
    part values. ERC 0.
    PCB: split the custom 2x8 Super Mini footprint into two standard 1x8
    sockets at the same pad positions, keep U2's module footprint, reattach
    the ESP32 3D model to U1A, reroute the IO6 track clear of U1B pin 1 and
    hide the U1 reference fields. DRC 0 errors / 0 unconnected; 24 silk
    warnings (baseline 28) and the 4 pre-existing H1-H4 parity notices.
    Aisler project BEAGDVXB: new revision imported, 10 assembled lines
    assigned to catalogue parts, J3 excluded as hand-solder. L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
    [cpl-aisler.csv, cpl-jlc.csv, cpl-jlcpcb.csv, cpl-pcbway.csv, esp32-c3-sensor-board-rev2-B_Cu.gbl, esp32-c3-sensor-board-rev2-B_Mask.gbs, esp32-c3-sensor-board-rev2-B_Silkscreen.gbo, esp32-c3-sensor-board-rev2-Edge_Cuts.gm1]
2026-10-31 Generate the JLCPCB package with the Fabrication Toolkit
    Install Fabrication Toolkit 5.3.1 and add a hidden LCSC field to every
    assembled footprint (and the matching LCSC/FT Rotation Offset properties
    to the schematic symbols). U2 gets FT Rotation Offset 90 because its
    custom ld2410c footprint has no standard-socket equivalent.
    Generate the JLCPCB package with the toolkit's headless CLI:
    gerbers zip, BOM, CPL and IPC netlist. J3 is filtered from the BOM/CPL
    because it is hand-soldered. The toolkit's CPL is part-centre and
    paired with its own gerber zip; the PCBWay CPL is converted to the
    bottom-left/Y-up part-centre convention.
    Docs cover the regeneration command and the upload pairing. ER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
    [bom-jlc.csv, bom-jlcpcb.csv, designators-jlcpcb.csv, esp32-c3-sensor-board-rev2.kicad_pcb, esp32-c3-sensor-board-rev2.kicad_sch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]
2026-10-31 Add rev3 with a full 1x16 breakout row
    Create hardware/esp32-c3-sensor-board-rev3.* from rev2 and expand J5
    from 1x14 to 1x16 in the numeric order: GPIO3 and GPIO4 now sit after
    GPIO2. The relay variant keeps J3/J4, so GPIO3/GPIO4 are available on
    both the terminals and J5; the compact variants drop J3/J4 and use the
    same full row.
    Schematic: J5 rebuilt as Conn_01x16 with all 16 global labels; ERC 0.
    PCB: J5 footprint replaced with the standard 1x16 socket, nets
    re-assigned, routing cleared and re-run with FreeRouting (0 unrouted),
    all tracks normalised to 0.25 mm, zones refilled and breakout labels
    replaced. DRC 0 errors / 0 unconnected; 26 warnings (2 new silk-over-
    mask vias); parity unc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
    [esp32-c3-sensor-board-rev3-B_Cu.gbl, esp32-c3-sensor-board-rev3-B_Mask.gbs, esp32-c3-sensor-board-rev3-B_Silkscreen.gbo, esp32-c3-sensor-board-rev3-Edge_Cuts.gm1, esp32-c3-sensor-board-rev3-F_Cu.gtl, esp32-c3-sensor-board-rev3-F_Mask.gts, esp32-c3-sensor-board-rev3-F_Silkscreen.gto, esp32-c3-sensor-board-rev3-job.gbrjob]
2026-10-31 Add the compact variant and clean both boards to zero DRC
    Create hardware/esp32-c3-sensor-board-compact.* from rev3: 46 x 72 mm
    R3, J3/J4 removed, the 1x16 J5 kept, relay/button branch traces removed,
    outline shortened and bottom holes moved to (3,69)/(43,69). The extra
    2 mm clears the J5 row and the mounting holes.
    Silk cleanup on rev3 and compact: J1/J2 module outlines moved outward,
    J1 reference hidden, relay module outline removed, J5/U2 side/top silk
    moved to the fab layer via project-local footprint copies
    (sensor-board:PinSocket_1x16_P2.54mm_Vertical and
    sensor-board:ld2410c_compact). The schematic footprint fields match.
    Results: both boards ERC 0, DRC 0 violations, 0 unconnected.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
    [BOM-compact.csv, BOM-rev3.csv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]
2026-10-31 Regenerate rev3 and compact order packages after final DRC
    Rebuild the rev3 and compact gerbers, drill files and zip archives from
    the final 0-violation boards so the files match the committed design.
    [esp32-c3-sensor-board-compact-B_Cu.gbl, esp32-c3-sensor-board-compact-B_Mask.gbs, esp32-c3-sensor-board-compact-B_Silkscreen.gbo, esp32-c3-sensor-board-compact-Edge_Cuts.gm1, esp32-c3-sensor-board-compact-F_Cu.gtl, esp32-c3-sensor-board-compact-F_Mask.gts, esp32-c3-sensor-board-compact-F_Silkscreen.gto, esp32-c3-sensor-board-compact-job.gbrjob]
2026-10-31 Redesign the compact board as a 34 x 76 stacked column
    Rotate the BH1750 90 degrees so its body is landscape and aligned with
    the LD2410C, rotate the BME280 90 degrees to a portrait body below it,
    and move J5 into the right-hand strip. The compact board is now
    34 x 76 mm: ESP32 at the top, radar/BH1750/BME280 stacked, J5 1x16 on
    the right, jumpers under the BME module, holes at (3,3), (31,3),
    (3,73), (31,73).
    Re-routed with FreeRouting at 0.25 mm tracks; added GND stitching vias
    and bottom GND tracks; refilled zones. DRC: 0 violations, 0 errors.
    KiCad still reports 3 GND-zone connectivity notices between pour
    islands; no pads or signal tracks are unconnected. ERC 0; parity only
    the 4 pre-ex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
    [BOM-compact.csv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]
2026-10-31 Add the compact 34x76 Fusion case and print files
    Fusion document "Sensorbox Compact v1" (Modules project) built around
    the imported compact board: 41 x 84 x 24 mm tray and press-fit cover,
    2 mm floor/walls, 1.5 mm PCB standoffs with M3 pilots, R3/R1.5 corners,
    two wall-mount keyholes, USB-C opening, J5 1x16 side slot, three ESP32
    side vents, three radar vents, BH1750 11x11 window, five BME280 louvres
    and internal cover walls at y -42.6/-24.4 for heat separation. No
    wiring channel; 3.5 mm perimeter margin.
    Export manifold STLs case/compact_tray.stl and compact_cover.stl, add
    case/README.md with print/fit notes, and update the compact variant and
    HANDOFF docs. Optional decorative faceplate o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
    [compact_cover.stl, compact_tray.stl]
2026-10-31 Add the compact stone faceplate and Blender generator
    39.5 x 82.5 x 3.9 mm plaque that sits on the compact cover (z 20.5), with
    the radar vents, BME280 louvres and an 11 x 11 BH1750 funnel. The relief is
    a heightfield sampled from Poly Haven "Rustic Stone Wall 02" (CC0), with a
    flat rim, border groove and a raised ring plus 16 rays around the light
    sensor. Manifold STL, prints bottom-face-down without supports.
    [compact_faceplate.blend, faceplate_compact.stl]
2026-11-01 Show the final boards, case and faceplate on the docs page
    Adds KiCad 3D renders of rev3 and compact, the compact case and stone
    faceplate previews, and a design-files table pointing at the PCB sources,
    order packages, STLs and Blender sources.
2026-11-01 Model the ESP32 on its header rows in the compact case
    The Fusion reference board had the Super Mini PCB sitting directly on the
    1x8 female sockets at 8.5 mm and no male pin rows. Added two
    PinHeader_1x08 rows at the socket origins with the long pins down, and
    moved the module to the real 11 mm stack (8.5 mm socket + 2.5 mm header
    plastic), with the STEP origin on the module PCB mid-plane. The document
    is now Sensorbox Compact v2.
2026-11-01 Redesign the compact case: lower roof, USB slot, mesh vents, partitions
    Roof down 1.5 mm to 22.5 mm total (limited by the ESP32 USB shell at
    16.6 mm and the sensor modules at 15.2 mm; 5 mm is not physically
    possible). The USB-C hole is now a stadium notch aligned with the
    connector and has a chamfered mouth. The BH1750 window is a single
    O5 sight hole, the radar and BME slots are replaced by discreet hole
    meshes, and both long walls get O1.6 vent holes. Full-height partition
    walls separate the ESP32, radar, BH1750 and BME280.
    Regenerates the tray, cover and faceplate STLs, the Blender scene and
    the renders; the Fusion master is Sensorbox Compact v5 (CASE_V2).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
    [compact_cover.stl, compact_faceplate.blend, compact_tray.stl, faceplate_compact.stl]
2026-11-01 Fill the J5 side slot and mirror the vent holes
    The 42 x 8.5 mm GPIO-breakout opening in the right wall is not needed.
    It is filled flush and the wall is recut with the same 36-hole pattern
    as the left wall, so both long sides are identical. J5 is now fully
    enclosed. Tray STL regenerated (8796 tris, manifold) and the assembly
    render updated.
    [compact_faceplate.blend, compact_tray.stl]
2026-11-01 Restore the ESP32 header rows and save Sensorbox Compact v6
    The two 1x8 header occurrences were back at the origin with the module
    at z 10.1 (the stack-fix transforms were lost during the case edits).
    Re-placed them at the socket origins with the 180-degree Y rotation and
    raised the module to the 11 mm stack. Fusion master is v6, which also
    carries the filled J5 wall.
2026-11-01 Snug the PCB, align the USB edge, thread the standoffs and split the case
    Cavity now x -0.5..34.5, y -76.5..0: 0.5 mm clearance left/right/bottom
    and the PCB's USB edge flush with the top inner wall; the USB notch is
    cut through the 4 mm wall so the plug reaches the connector. The four
    standoffs carry modeled M3x0.5 threads, and the cover has four bosses
    with clearance holes and flush counterbores; M3x20 screws clamp the PCB
    and lid. Lid and base are separate BASE/LID components.
    [compact_cover.stl, compact_faceplate.blend, compact_tray.stl]
2026-11-01 Thread all four mounts and bake the ESP32 stack into geometry
    Only one standoff had a modelled thread; the original ThreadFeature did
    not apply to the whole face collection. Added one M3x0.5 thread feature
    per hole, so all four are threaded (tray STL 17100 tris, manifold).
    The imported ESP32 and header occurrence transforms kept reverting on
    document versions. Added ESP32_FIXED bodies with the module and both
    header rows transformed to their correct world positions and hid the
    original occurrences, so the 11 mm stack cannot revert again. Fusion
    document is Sensorbox Compact v8.
    [compact_faceplate.blend, compact_tray.stl]
2026-11-01 Reverse the lid screws to enter from the bottom
    The four lid poles now carry modelled M3x0.5 blind threads (8 mm deep)
    and the lid top is solid; the screw holes and counterbores are gone from
    the lid. The base floor and standoffs have O3.2 clearance holes with
    O6.6 x 1.7 mm countersinks, so M3x12 countersunk screws go up from the
    bottom, through the PCB, into the lid poles; the heads sit flush and do
    not protrude. The two keyhole slots remain the wall mount.
    [compact_cover.stl, compact_faceplate.blend, compact_tray.stl]
2026-11-01 Notch the lid lip around the USB-C port
    The lip overlapped the back of the USB-C receptacle by 0.2 mm. Cut a
    stadium notch through the lip from y -1.7 outward over the connector
    width and height, following the port curve. LID vs ESP32 interference
    is now zero; cover STL 22276 tris, manifold. Fusion master v10.
    [compact_cover.stl, compact_faceplate.blend]
2026-11-01 Add a single keyhole pod and a lid edge stadium groove
    Replaced the two floor keyhole slots with one keyhole in a O28 x 5 mm
    pod on the back. The keyhole is in the pod's back plate; the wall screw
    head sits in the 3 mm cavity between that plate and the sealed floor,
    so the metal cannot reach the PCB. The case stands 5 mm off the wall on
    the pod.
    The lid outer edge now has a 9.4 x 2 mm stadium groove with r1.0 ends
    through the edge at the USB port, continuing the base opening curve;
    the faceplate covers the top. Tray 9960 tris, cover 22380 tris, both
    manifold. Fusion master v11.
    [compact_cover.stl, compact_faceplate.blend, compact_tray.stl]
2026-11-01 Split the wall-mount pod into its own body and align the lid groove
    The keyhole pod is now a separate MOUNT body/component (compact_mount
    .stl, O28 x 5 mm cup). The base back is flat; the pod's open face is
    glued to it and the solid floor seals the screw cavity from the PCB.
    The lid edge groove is re-cut to the base outer chamfer profile: same
    1.5 mm depth, same width at the junction (9.56 mm) and a curved bottom,
    with vertical sides through the lid edge. LID vs ESP32 interference is
    zero. Tray 9276 tris, cover 22404 tris, mount 1052 tris; all manifold.
    Fusion master v12.
    [compact_cover.stl, compact_faceplate.blend, compact_mount.stl, compact_tray.stl]
2026-11-01 Rebuild the USB-C cutouts from the measured port
    Measured the ESP32 shell front face: 9.0 x 3.12 mm, r1.56, centre
    (x 17, z 15.05). Filled the old wall and lid cuts and recut both on that
    centre: wall opening 9.6 x 4.0, r1.0, with a 10.8 x 4.6 r1.2 outer
    chamfer; lid lip the same 9.6 x 4.0 profile; lid edge slot 9.6 x 2.0,
    r1.0. Wall and lid cutouts are now concentric with the port; ESP32
    interference is zero. Tray 9284 tris, cover 22540, mount 1052; all
    manifold. Fusion master v13.
    [compact_cover.stl, compact_faceplate.blend, compact_tray.stl]
2026-11-01 Make the USB slot full width at the wall/lid junction
    The wall and lid lip cutouts now use a rounded-bottom slot 9.6 mm wide,
    z 13.05-17.0, r0.5 bottom corners and full width at the top, centred on
    the measured port (x 17, z 15.05). It continues into the straight
    9.6 x 2 mm lid edge slot, so the wall and lid cutouts meet with no step.
    ESP32 interference is zero; tray 9244 tris, cover 22412; manifold.
    Fusion master v15.
    [compact_cover.stl, compact_faceplate.blend, compact_tray.stl]
2026-11-02 Restore the lid USB-C edge slot in the compact case
    Sensorbox Compact v16 lost the 9.6 x 2 mm slot through the lid edge, so the
    lid left a 2 mm brow over the USB-C opening and a plug overmold could not
    pass. Re-cut the slot concentrically with the port (x 12.2-21.8,
    z 17.0-19.0, y 2.5-4.0), meeting the base opening and the underside relief.
    Re-exported compact_cover.stl (22272 tris, manifold) and updated the v16
    document references.
    [compact_cover.stl]
2026-11-02 Point the compact case docs at Sensorbox Compact v17
    The Fusion save versioned the document from v16 to v17.
2026-11-02 Continue the base USB-C recess into the lid
    Replace the separate 9.6 x 2 mm lid notch with the completion of the base's
    outer recess: the same 10.8 x 4.6 mm rounded rectangle (r1.2, 1 mm deep) is
    cut into the lid from z 17.0 to 17.35, completing the top corner arcs and
    flat top. Assembled, the wall and lid read as one continuous USB-C opening
    with the parting line hidden inside the corner arcs. Re-exported the cover
    STL (22284 tris, manifold); base/tray unchanged.
    [compact_cover.stl]
2026-11-02 Point the compact case docs at Sensorbox Compact v18
    The Fusion save versioned the document from v17 to v18.
